TakoyakiFuwa/DCDC/EDA/product/Battery28V_2026-06-20.png

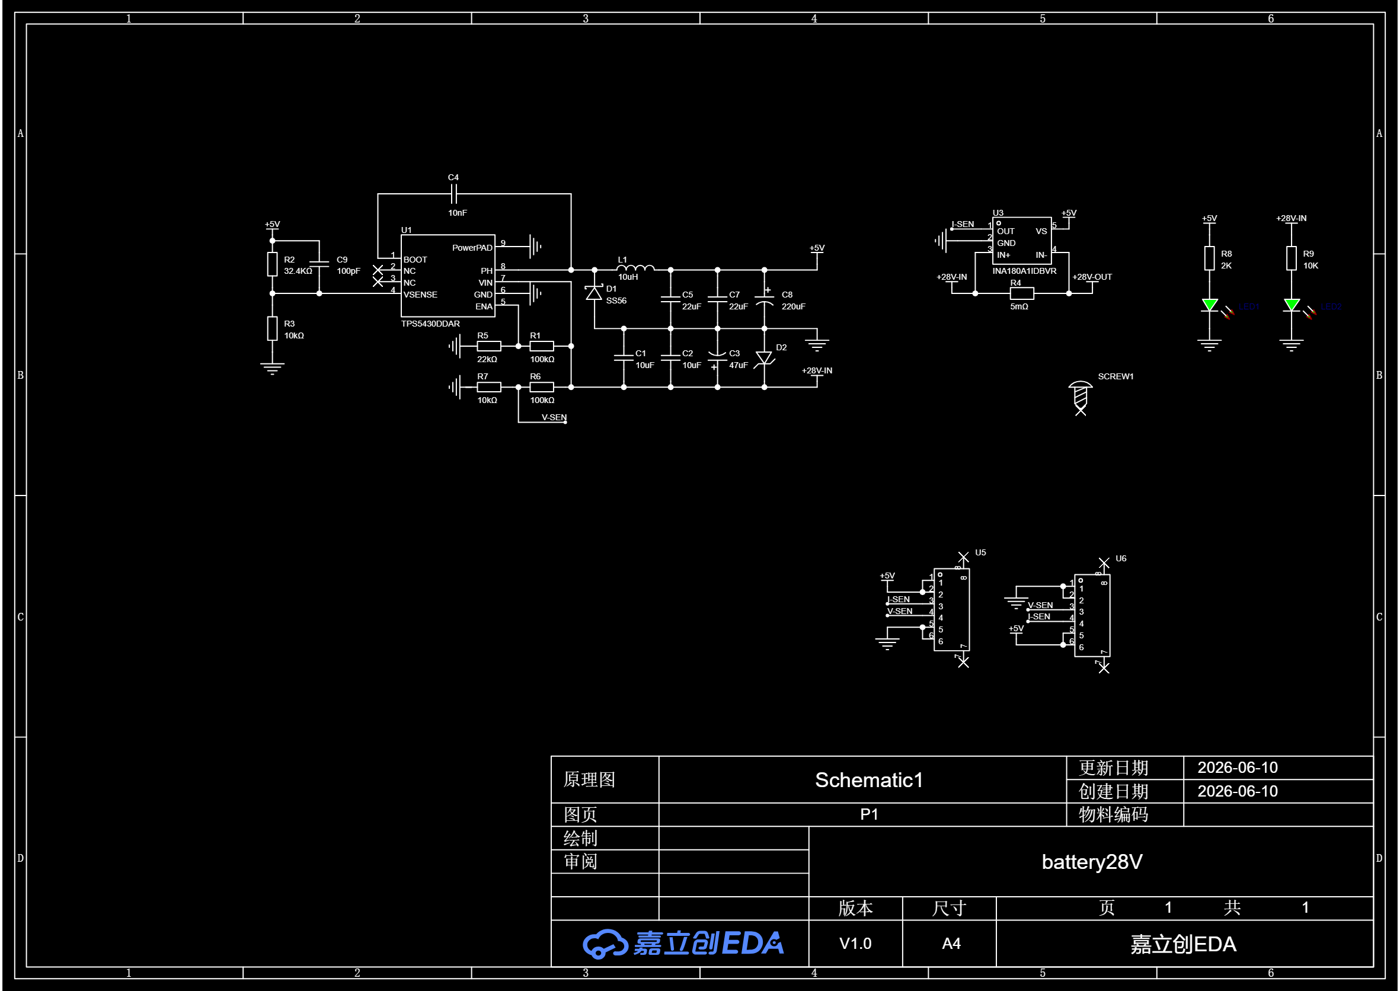
EDA/product/Battery28V_2026-06-20.png
