TakoyakiFuwa/DCDC/EDA/product/Battery28V_2026-06-21.png

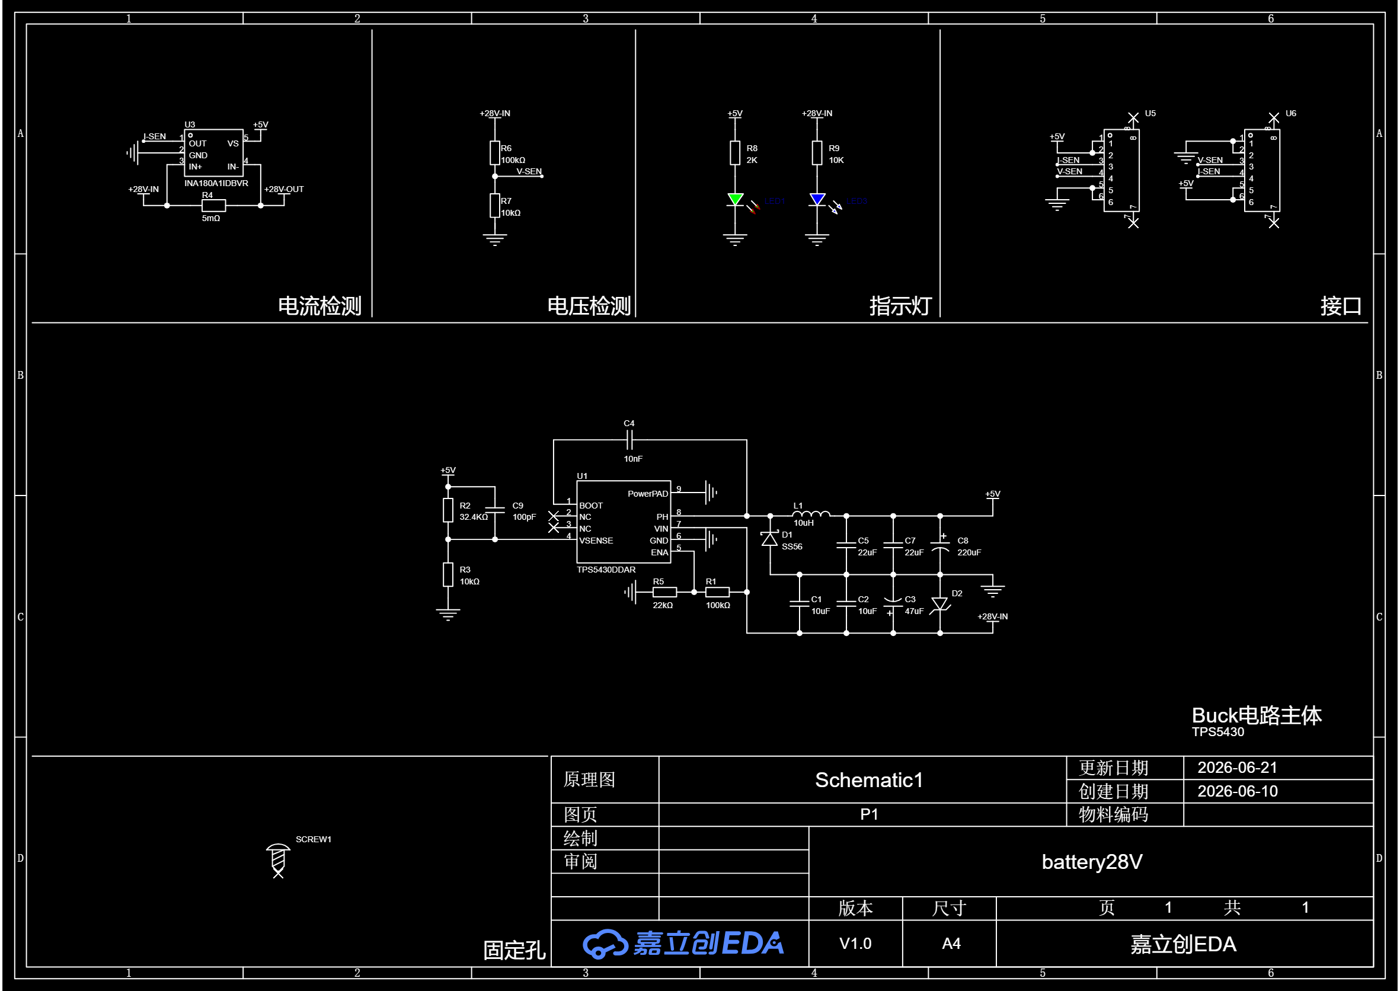
EDA/product/Battery28V_2026-06-21.png
