TakoyakiFuwa/DCDC/EDA/product/Battery28V_PCB1_2026-06-21.png

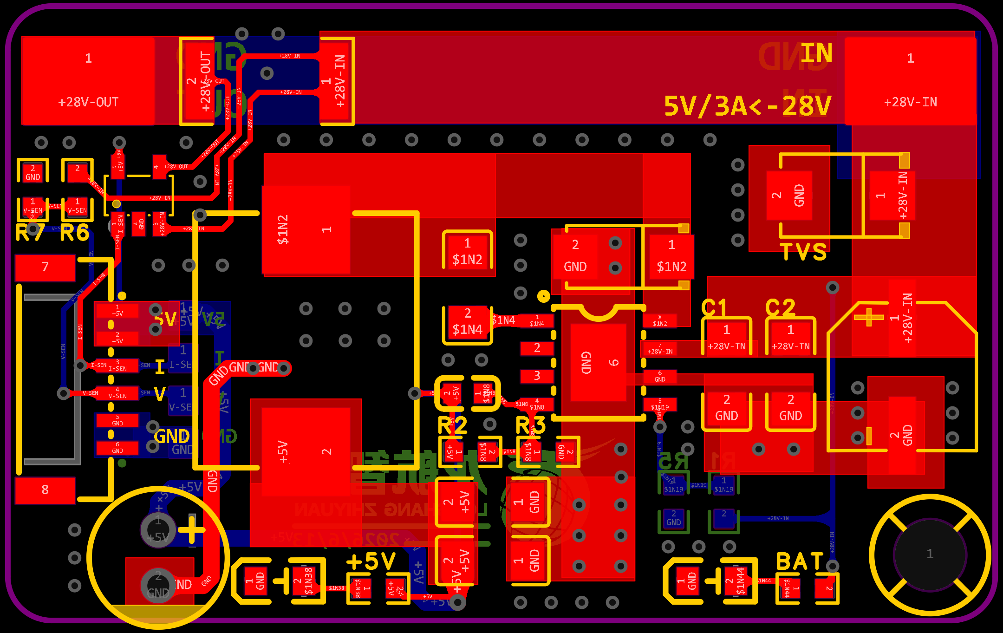
EDA/product/Battery28V_PCB1_2026-06-21.png
