TakoyakiFuwa/DCDC/EDA/product/SCH_Schematic1_1-P1_2026-06-13.png

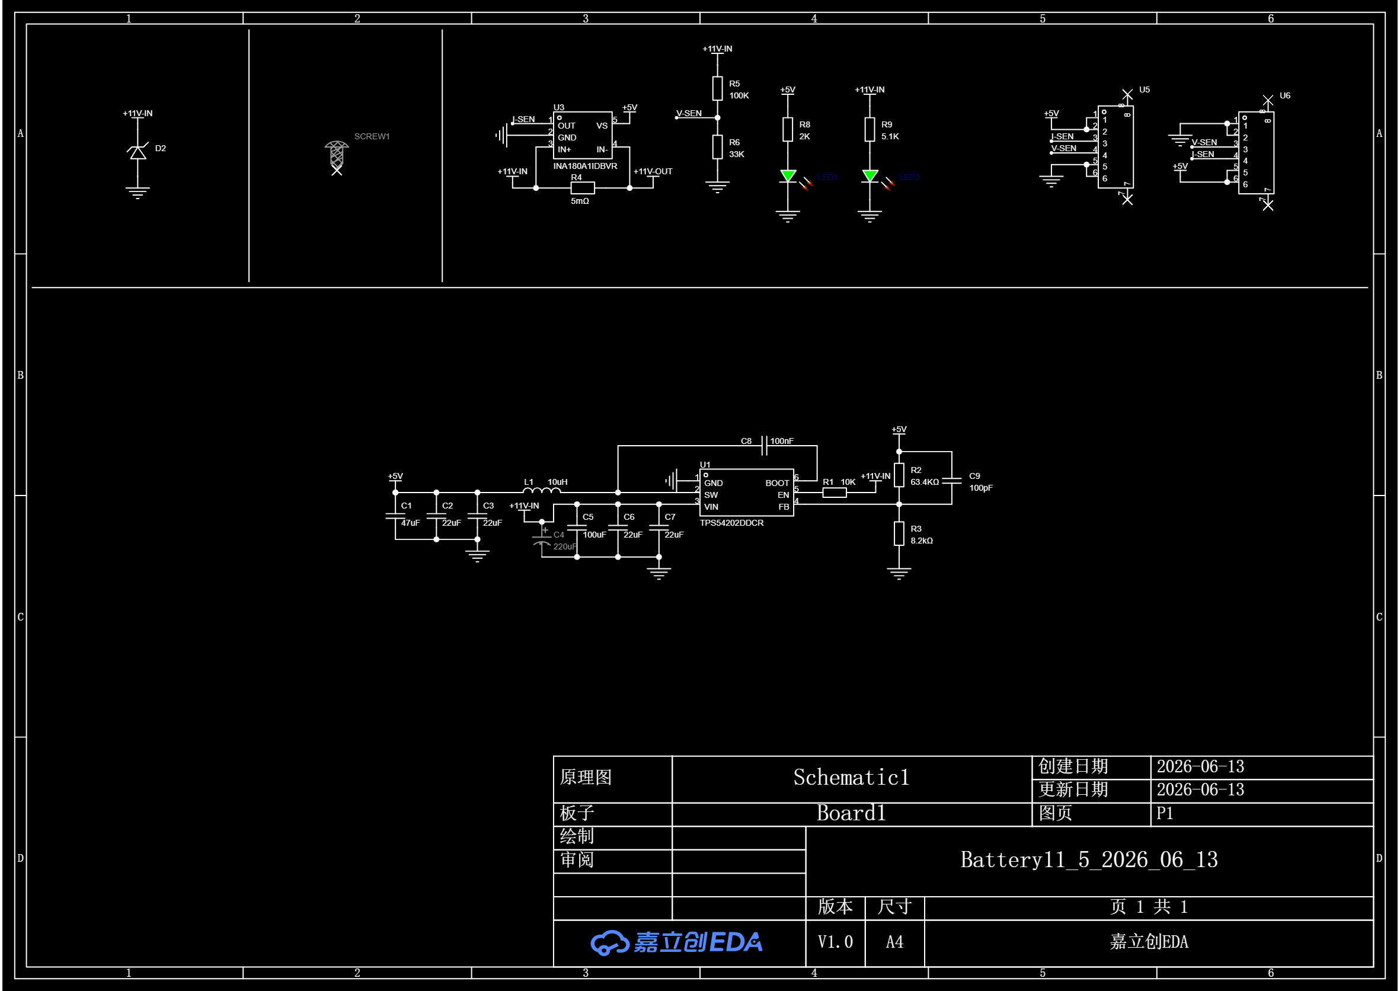
EDA/product/SCH_Schematic1_1-P1_2026-06-13.png
