TakoyakiFuwa/DCDC/EDA/product/BOM_Board1_Schematic1_2026-06-04.xlsx

No. | Quantity | Comment | Designator | Footprint | Value | Manufacturer Part | Manufacturer | Supplier Part | Supplier
1 | 7 | 47uF | C1,C4,C10,C29,C30,C31,C36 | CAP-SMD_BD6.3-L6.6-W6.6-LS7.3-FD | 47uF | RV50V47M6X5 | JIERR(捷而瑞) | C48971023 | LCSC
2 | 6 | 22uF | C2,C3,C5,C6,C11,C12 | C0805 | 22uF
3 | 12 | 10uF | C7,C13,C14,C21,C22,C23,C25,C27,C32,C33,C34,C35 | C0805 | 10uF
4 | 2 | 20pF | C8,C16 | C0805 | 20pF
5 | 6 | 100nF | C9,C15,C17,C20,C24,C26 | C0805 | 100nF
6 | 3 | 16pF | C18,C19,C28 | C0805 | 16pF
7 | 2 | SS34 | D1,D2 | SMA_L4.3-W2.6-LS5.0-FD |  | SS34 | R+O(宏嘉诚) | C7420365 | LCSC
8 | 1 | MK-12C01N-G1.5 | EN1 | SW-SMD_DEALON_MK-12C01N-G1.5 |  | MK-12C01N-G1.5 | DEALON(德艺隆) | C2904923 | LCSC
9 | 1 | AFC07-S08ECA-00 | FPC2 | FPC-SMD_P0.5-8P_LCS-SH-H2.0 |  | AFC07-S08ECA-00 | JS(钜硕电子) | C262581 | LCSC
10 | 6 | HDR-M_2.54_1x2P | H1,H5,H6,H7,H18,H23 | HDR-TH_2P-P2.54-V-M-1 |  |  |  | C124375
11 | 1 | HDR-M_2.54_1x3P | H2 | HDR-TH_3P-P2.54-V-M |  |  |  | C2937625
12 | 1 | HDR-M_2.54_1x6P | H3 | HDR-TH_6P-P2.54-V-M-1 |  |  |  | C37208
13 | 1 | HDR-M_2.54_1x5P | H4 | HDR-TH_5P-P2.54-V-M |  |  |  | C358687
14 | 2 | HDR-M_2.54_1x4P | H8,H15 | HDR-TH_4P-P2.54-V-M |  |  |  | C492403
15 | 1 | HDR-M_2.54_2x9 | H13 | HDR-TH_18P-P2.54-V-M-R2-C9-S2.54 |  |  |  | C492426
16 | 2 | HDR-F_2.54_2x4 | H16,H19 | HDR-TH_8P-P2.54-V-F-R2-C4-S2.54-1 |  |  |  | C92271
17 | 2 | HDR-M_2.54_2x2 | H22,H24 | HDR-TH_4P-P2.54-V-M-R2-C2-S2.54-1 |  |  |  | C160338
18 | 1 | 4.7uH | L1 | IND-SMD_L7.4-W6.6_SRG0630 | 4.7uH | SRG0630-4R7-M | JIERR(捷而瑞) | C53462987 | LCSC
19 | 1 | 10uH | L2 | IND-SMD_L7.4-W6.6_SRG0630 | 10uH | SRG0630-100-M | JIERR(捷而瑞) | C53462991 | LCSC
20 | 1 | 10uH | L3 | L0805 | 10uH
21 | 2 | HL-A-5730D1W-S1-08-HR3(LY) | LED1,LED2 | LED-SMD_3P-L5.7-W3.0-RD |  | HL-A-5730D1W-S1-08-HR3(LY) | HONGLITRONIC(鸿利光电) | C210349 | LCSC
22 | 3 | LED_0805-G | LED3,LED5,LED7 | LED_0805
23 | 1 | LED_0805-R | LED4 | LED_0805
24 | 1 | LED_0805-B | LED6 | LED_0805
25 | 2 | AO3400A | Q1,Q2 | SOT-23-3_L2.9-W1.3-P1.90-LS2.4-BR |  | AO3400A | UMW(友台半导体) | C347475 | LCSC
26 | 1 | 140K | R1 | R0805 | 140K
27 | 1 | 6.34K | R2 | R0805 | 6.34K
28 | 4 | 5.1K | R3,R6,R17,R18 | R0805 | 5.1K
29 | 1 | 73.2K | R4 | R0805 | 73.2K
30 | 5 | 10K | R5,R10,R11,R12,R38 | R0805 | 10K
31 | 6 | 1K | R7,R8,R34,R35,R36,R40 | R0805 | 1K
32 | 2 | 1M | R9,R13 | R0805 | 1M
33 | 1 | 1.5K | R14 | R0805 | 1.5K
34 | 3 | 2K | R15,R16,R39 | R0805 | 2K
35 | 1 | 100K | R19 | R0805 | 100K
36 | 1 | 33K | R20 | R0805 | 33K
37 | 4 | 0.1R | R21,R22,R23,R37 | R0805 | 0.1R
38 | 2 | 10R | R24,R25 | R0805 | 10R
39 | 8 | 220Ω | R26,R27,R28,R29,R30,R31,R32,R33 | R2512 | 220Ω | FRC2512J221TS | FOJAN(富捷) | C2930459 | LCSC
40 | 4 | M3螺丝 | SCREW1,SCREW2,SCREW3,SCREW4 | M3螺丝
41 | 2 | HX-2x4x3.5CA-2.5N | SW1,SW2 | SW-SMD_HX-2X4X3.5CA-2.5N |  | HX-2x4x3.5CA-2.5N | hanxia(韩下) | C49234137 | LCSC
42 | 1 | MT3608 | U1 | SOT-23-6_L2.9-W1.6-P0.95-LS2.8-BL |  | MT3608 | 西安航天民芯 | C84817 | LCSC
43 | 1 | TPS54202DDCR | U2 | SOT-23-6_L2.9-W1.6-P0.95-LS2.8-BL |  | TPS54202DDCR | TI(德州仪器) | C191884 | LCSC
44 | 1 | STM32F103C8T6 | U3 | LQFP-48_L7.0-W7.0-P0.50-LS9.0-BL |  | STM32F103C8T6 |  | C9900100366 | LCSC
45 | 1 | TP4056X-42-ESOP8 | U4 | SOP-8_L4.9-W3.9-P1.27-LS6.0-TL-EP |  | TP4056X-42-ESOP8 | TOPPOWER(南京拓微) | C2763448 | LCSC
46 | 1 | ME6206A33PG | U5 | SOT-89-3_L4.5-W2.5-P1.50-LS4.2-BR |  | ME6206A33PG | MICRONE(南京微盟) | C79022 | LCSC
47 | 4 | INA180A2IDBVR(XBLW) | U6,U7,U8,U10 | SOT-23-5_L3.0-W1.7-P0.95-LS2.8-BR |  | INA180A2IDBVR(XBLW) | XBLW(芯伯乐) | C47021222 | LCSC
48 | 1 | BL-DT | U9 | SW-SMD_BL-DT |  | BL-DT | SHOU HAN(首韩) | C53223909 | LCSC
49 | 1 | CH340N | U11 | SOP-8_L4.9-W3.9-P1.27-LS6.0-BL |  | CH340N | WCH(南京沁恒) | C2977777 | LCSC
50 | 1 | TYPE-C 16P QTWT | USB1 | USB-TYPE-C-SMD_TYPE-C-16P-QTWT |  | TYPE-C 16P QTWT | SHOU HAN(首韩) | C5187472 | LCSC
51 | 2 | AF 10.0 QT-ZB6.8 | USB2,USB3 | USB-A-SMD_AF-10.0-QT-ZB6.8 |  | AF 10.0 QT-ZB6.8 | SHOU HAN(首韩) | C456016 | LCSC
52 | 1 | 10.0 QTJ6.3 | USB4 | USB-A-SMD_10.0-QTJ6.3 |  | 10.0 QTJ6.3 | SHOU HAN(首韩) | C404966 | LCSC
53 | 1 | 8MHz | X1 | CRYSTAL-SMD_L11.5-W4.8-LS12.7 | 8MHz | X49SM8MSD2SC | YXC(扬兴晶振) | C12674 | LCSC
54 | 1 | 32.768kHz | X2 | MC-306_4P-L8.0-W3.2-P5.5-BL | 32.768kHz | Q13MC30610003 | EPSON(爱普生) | C16320 | LCSC
