TakoyakiFuwa/DCDC/EDA/product/Battery_2026-06-26.xlsx

No. | Quantity | Comment | Designator | Footprint | Value | Manufacturer Part | Manufacturer | Supplier Part | Supplier
1 | 2 | 10uF | C1,C2 | C1206 | 10uF | HGC1206R7106K500NSPJ | Chinocera(华瓷) | C33546013 | LCSC
2 | 1 | 47uF | C3 | CAP-SMD_BD6.3-L6.6-W6.6-LS7.6-FD | 47uF | RVT1H470M0607 | ROQANG(容强) | C72523 | LCSC
3 | 1 | 10nF | C4 | C1206 | 10nF | 1206B103K102NT | FH(风华) | C9194 | LCSC
4 | 2 | 22uF | C5,C7 | C1206 | 22uF | CL31B226KPHNNNE | SAMSUNG(三星) | C87996 | LCSC
5 | 1 | 220uF | C8 | CAP-TH_BD6.3-P2.50-D1.0-FD | 220uF | 25YXJ220M6.3X11 | Rubycon(红宝石) | C88729 | LCSC
6 | 1 | 100pF | C9 | C0603 | 100pF | CC0603JRNPO9BN101 | YAGEO(国巨) | C14665 | LCSC
7 | 1 | SS56 | D1 | SMA_L4.3-W2.6-LS5.2-RD |  | SS56 | MDD(辰达半导体) | C65009 | LCSC
8 | 1 | SMBJ33A | D2 | SMB_L4.6-W3.6-LS5.3-RD |  | SMBJ33A | Littelfuse(美国力特) | C224019 | LCSC
9 | 1 | 10uH | L1 | IND-SMD_L11.6-W10.1 | 10uH | CYA1040-10UH | SHOU HAN(首韩) | C6364677 | LCSC
10 | 1 | KT-0805G | LED1 | LED_0805 |  | KT-0805G | KENTO | C2297 | LCSC
11 | 1 | LTST-C170TBKT | LED3 | LED_0805 |  | LTST-C170TBKT | LITEON(光宝) | C98222 | LCSC
12 | 2 | 100kΩ | R1,R6 | R0603 | 100kΩ | AC0603FR-0710KL | YAGEO(国巨) |  | LCSC
13 | 1 | 32.4KΩ | R2 | R0603 | 32.4KΩ | AC0603FR-0710KL | YAGEO(国巨) |  | LCSC
14 | 1 | 10kΩ | R3 | R0603 | 10kΩ | AC0603FR-0710KL | YAGEO(国巨) | C116677 | LCSC
15 | 1 | 5mΩ | R4 | R2512 | 5mΩ | JER2512F3R005 | JIERR(捷而瑞) | C46634460 | LCSC
16 | 1 | 22kΩ | R5 | R0603 | 22kΩ | AC0603FR-0710KL | YAGEO(国巨) |  | LCSC
17 | 1 | 10kΩ | R7 | R0603 | 10kΩ | AC0603FR-0710KL | YAGEO(国巨) |  | LCSC
18 | 1 | 2K | R8 | R0603 | 2K
19 | 1 | 10K | R9 | R0603 | 10K
20 | 1 | M3螺丝 | SCREW1 | M3螺丝
21 | 1 | TPS5430DDAR | U1 | ESOP-8_L4.9-W3.9-P1.27-LS6.0-TL-EP |  | TPS5430DDAR | TI(德州仪器) | C9864 | LCSC
22 | 1 | INA180A1IDBVR | U3 | SOT-23-5_L3.0-W1.7-P0.95-LS2.8-BR |  | INA180A1IDBVR | TI(德州仪器) | C122228 | LCSC
23 | 2 | 1.25-6PWTDK | U5,U6 | CONN-SMD_6P-P1.25_GH1.25-6PWBPZ |  | 1.25-6PWTDK | SHOU HAN(首韩) | C3008556 | LCSC
