TakoyakiFuwa/DCDC/(commit log)

2026-05-27 完成前级
2026-05-27 完成14V降1.8~12V
2026-05-29 完成原理图
2026-05-29 在画PCB
2026-05-29 在元器件布局
2026-05-29 基础布线完成
2026-05-29 完成布线
2026-05-31 更新readme.md
2026-06-10 28V电池降压5V3A
2026-06-13 11.5V降压5V2A
    [BOM_Board1_Schematic1_2026-06-04.xlsx]
2026-06-27 更新readme
    [Battery_2026-06-26.xlsx]
2026-07-05 TestCode->添加ADC屏幕显示，高精度ADC
2026-07-05 TestCode->添加按键
2026-07-31 数控电源
2026-08-03 完成数控电源
